Protocentral/protocentral_easyemg_hardware/hardware/protocentral-easyemg-schematic.pdf

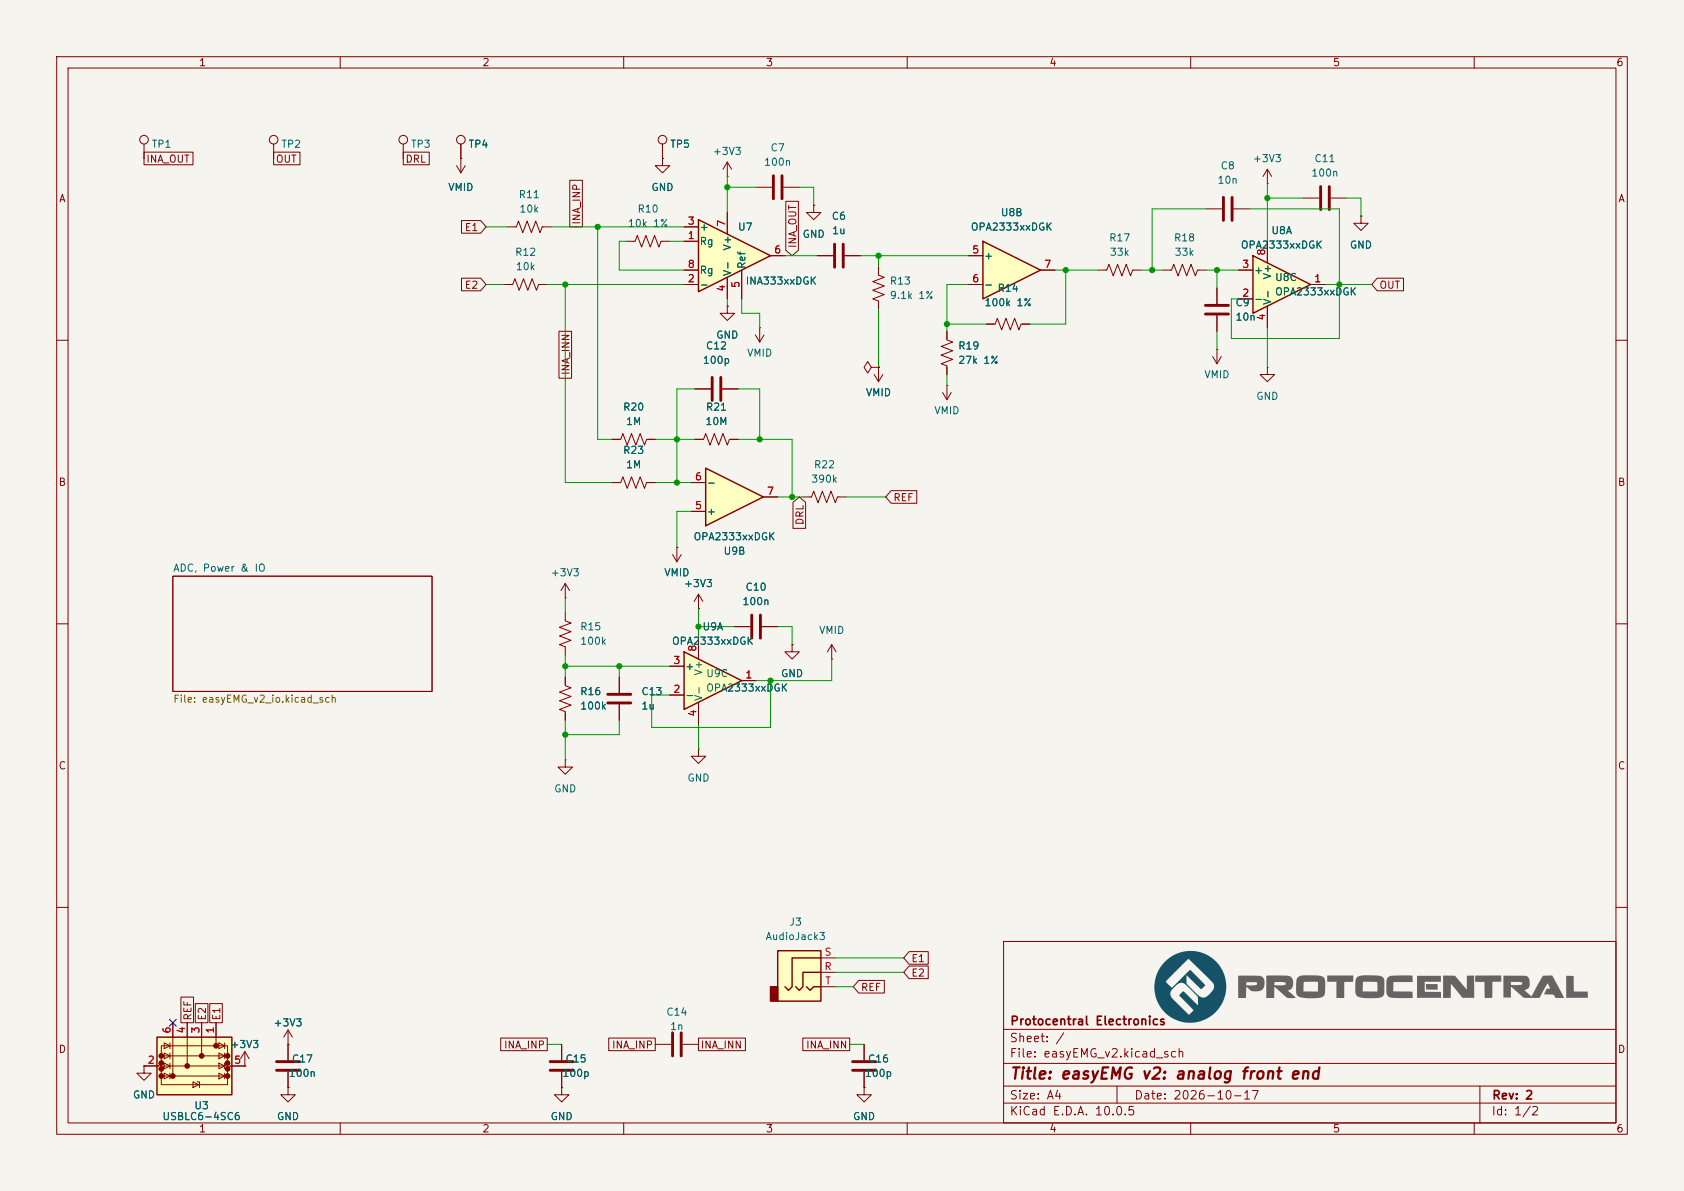
[picture p2: page 1]

Protocentral Electronics
Sheet: /
File: easyEMG_v2.kicad_sch
Title: easyEMG v2: analog front end

Size: A4 | Rev: 2
KiCad E.D.A. 10.0.5 | Id: 1/2

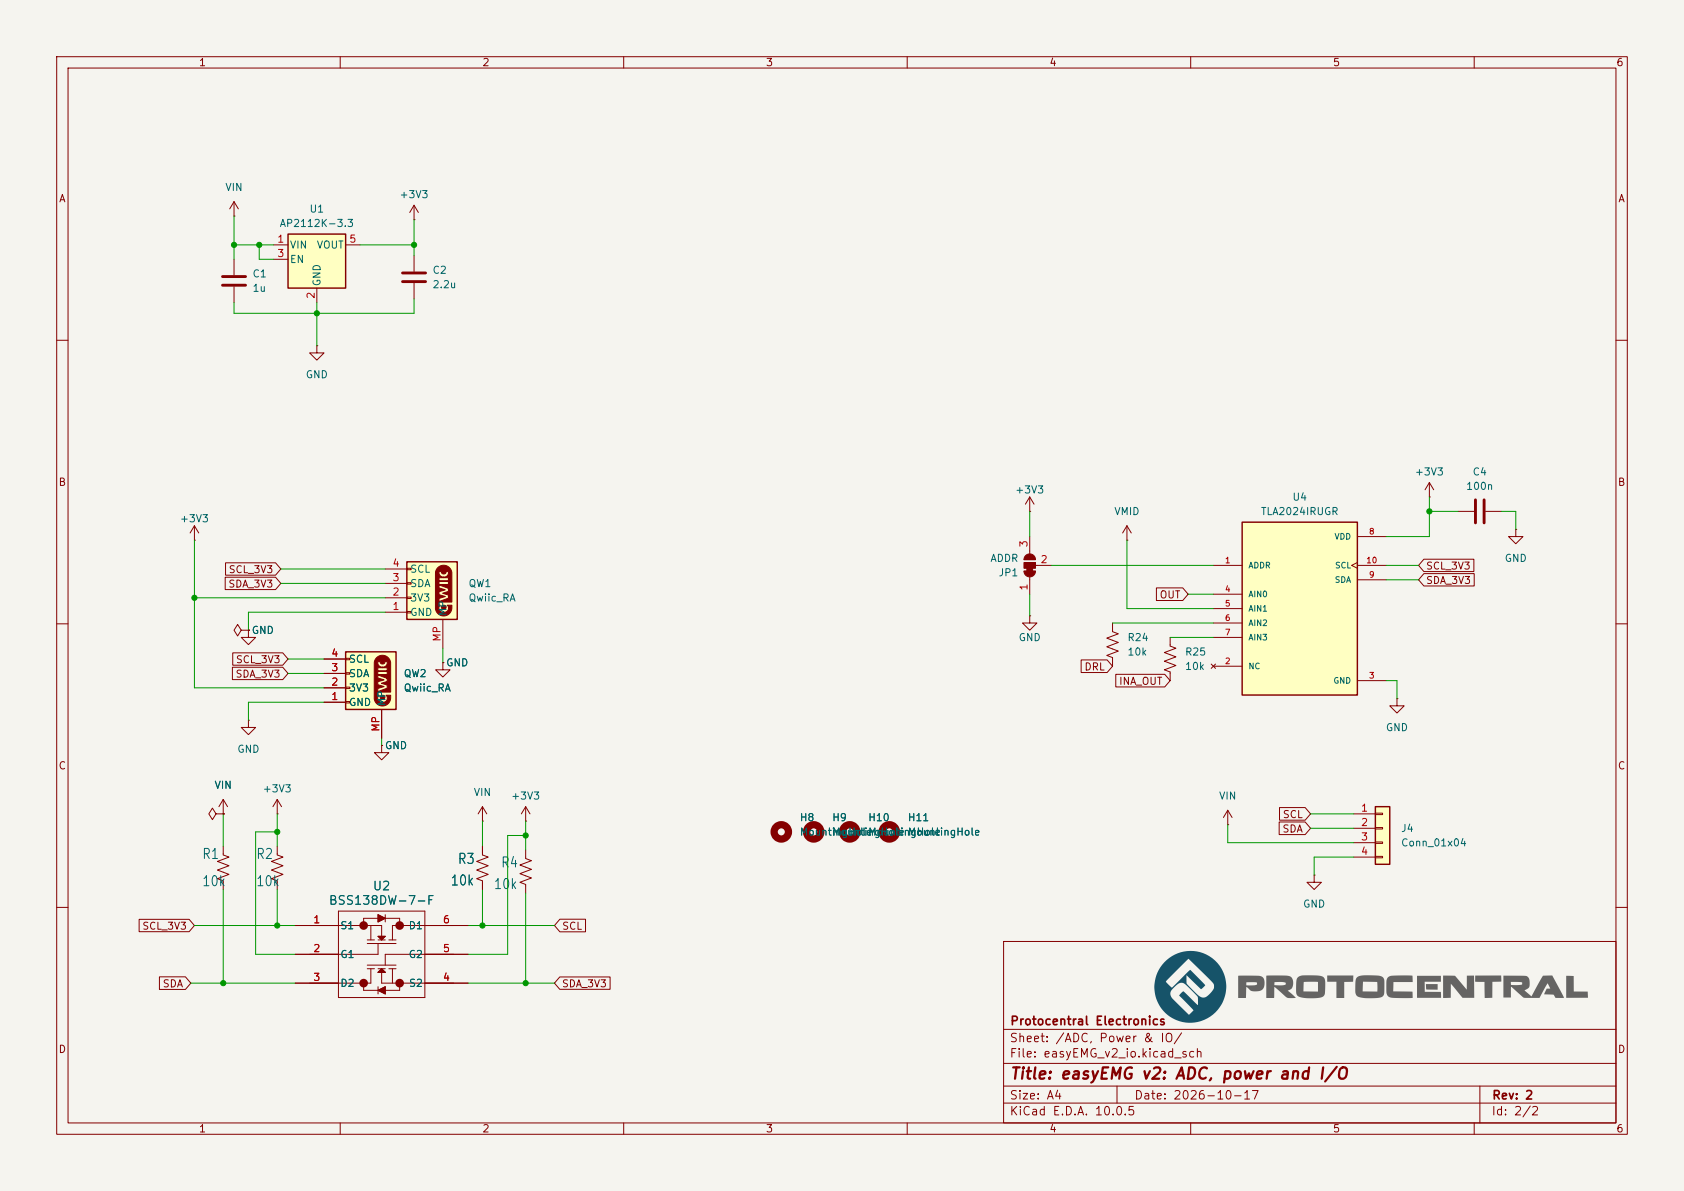
[picture p3: page 2]

Sheet: /ADC, Power & IO/
File: easyEMG_v2_io.kicad_sch
Title: easyEMG v2: ADC, power and I/O

Size: A4 | Rev: 2
KiCad E.D.A. 10.0.5 | Id: 2/2
