Protocentral/protocentral_easyemg_hardware/hardware/easyEMG_v2.kicad_pcb

## KiCad design hardware/easyEMG_v2.kicad_pcb (2026-11-07)

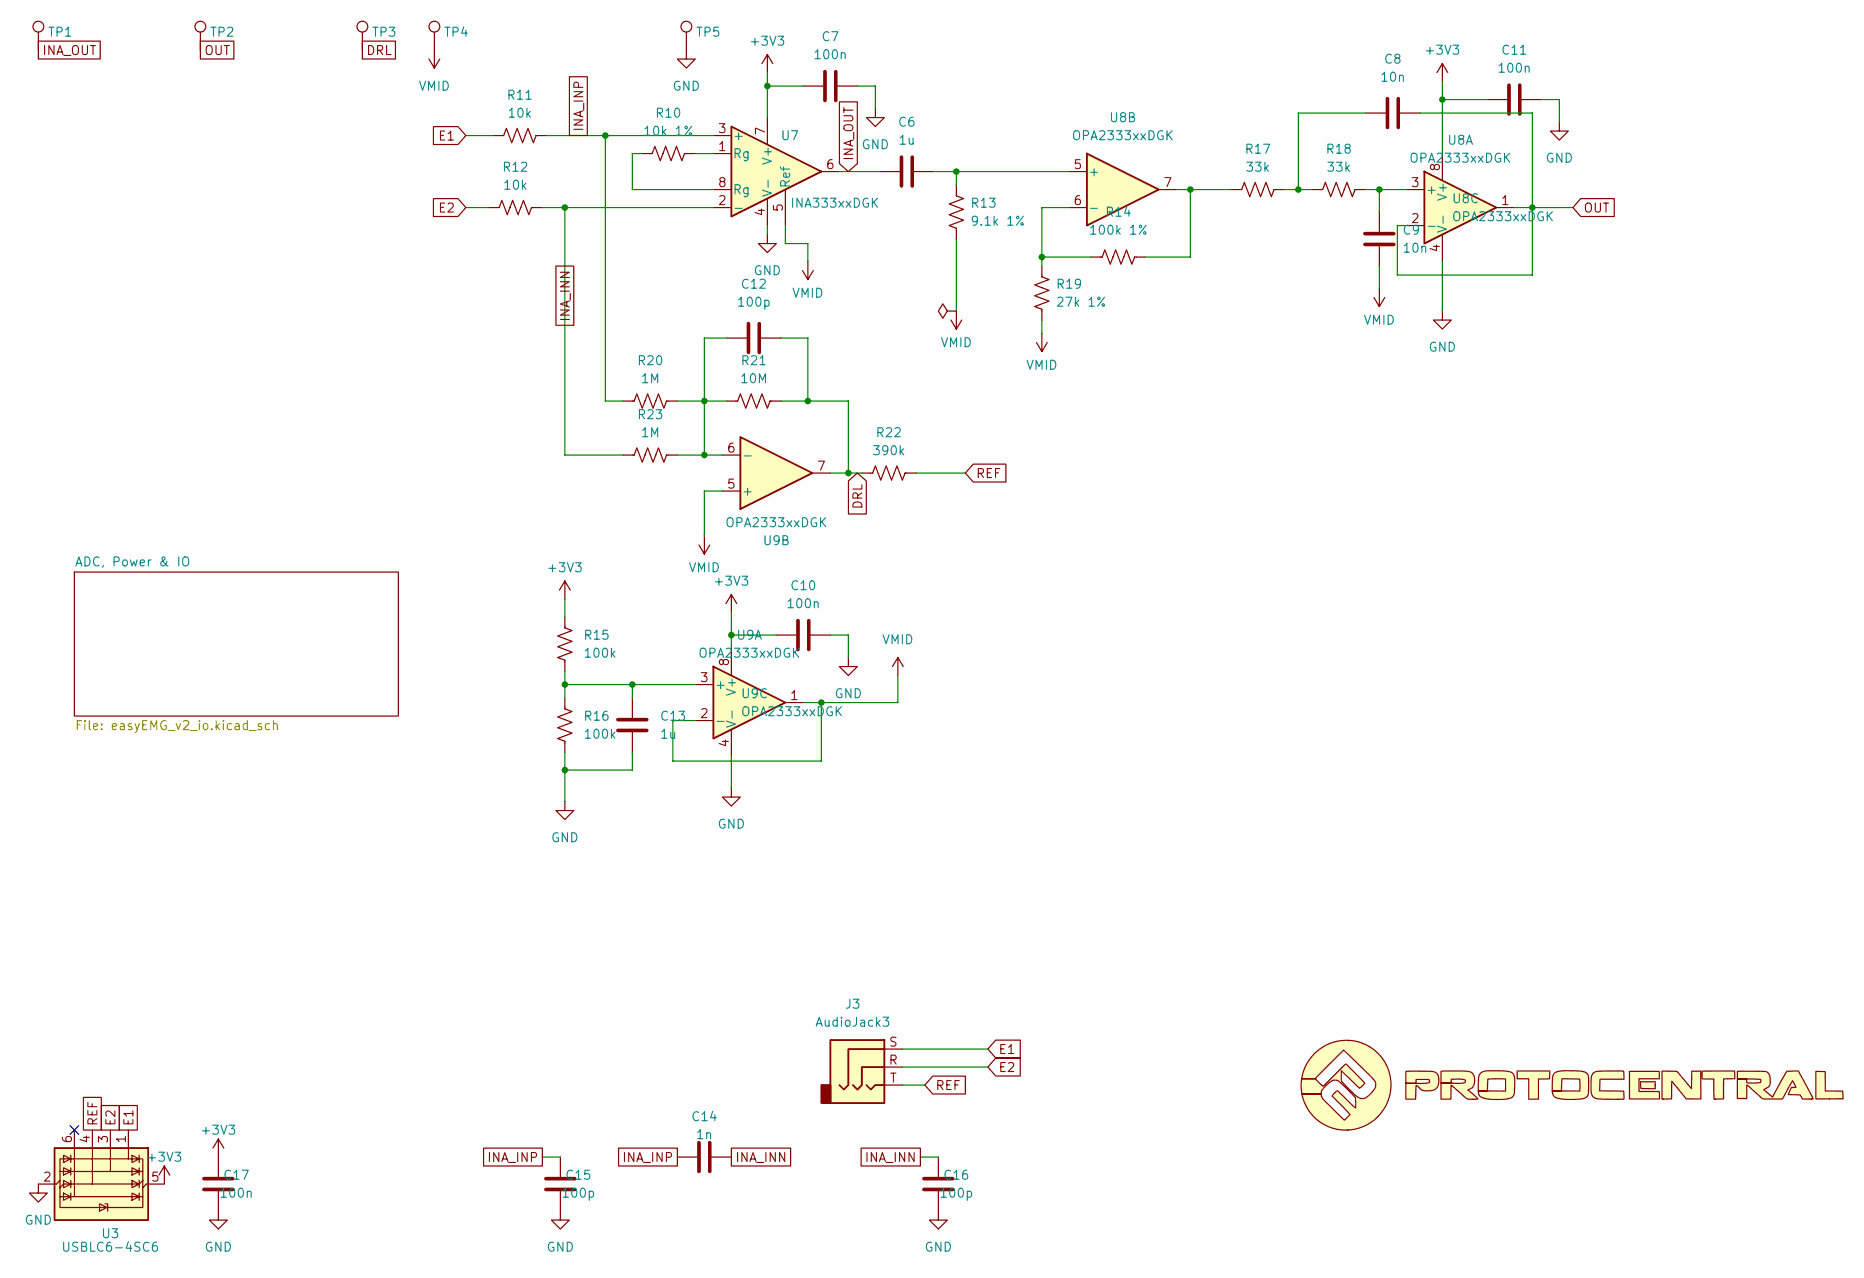
[picture p4: schematic easyEMG_v2.kicad_sch, easyEMG v2: analog front end]

Parts:
C6, C13: 1u; C_0402_1005Metric
C7, C10, C11, C17: 100n; C_0402_1005Metric
C8, C9: 10n; C_0402_1005Metric
C12, C15, C16: 100p; C_0402_1005Metric
C14: 1n; C_0402_1005Metric
J3: AudioJack3; Jack_3.5mm_CUI_SJ-3523-SMT_Horizontal
R10: 10k 1%; R_0402_1005Metric
R11, R12: 10k; R_0402_1005Metric
R13: 9.1k 1%; R_0402_1005Metric
R14: 100k 1%; R_0402_1005Metric
R15, R16: 100k; R_0402_1005Metric
R17, R18: 33k; R_0402_1005Metric
R19: 27k 1%; R_0402_1005Metric
R20, R23: 1M; R_0402_1005Metric
R21: 10M; R_0402_1005Metric
R22: 390k; R_0402_1005Metric
TP1: INA_OUT; TestPoint_Pad_D1.0mm
TP2: OUT; TestPoint_Pad_D1.0mm
TP3: DRL; TestPoint_Pad_D1.0mm
TP4: VMID; TestPoint_Pad_D1.0mm
TP5: GND; TestPoint_THTPad_D1.5mm_Drill0.7mm
U3: USBLC6-4SC6; SOT-23-6
U6: LOGO
U7: INA333xxDGK; VSSOP-8_3x3mm_P0.65mm
U8, U9: OPA2333xxDGK; VSSOP-8_3x3mm_P0.65mm

Connections:
+3V3: C7.2, C10.2, C11.2, C17.1, R15.1, U3.5 (VBUS), U7.7 (V+), U8.8 (V+), U9.8 (V+); also elsewhere on the board
DRL: C12.1, R21.2, R22.1, TP3.1 (1_1), U9.7; also elsewhere on the board
E1: J3.S, R11.1, U3.1 (I/O1)
E2: J3.R, R12.1, U3.3 (I/O2)
GND: C7.1, C10.1, C11.1, C13.2, C15.2, C16.2, C17.2, R16.2, TP5.1 (1_1), U3.2 (GND), U7.4 (V-), U8.4 (V-), U9.4 (V-); also elsewhere on the board
INA_INN: C14.2, C16.1, R12.2, R23.1, U7.2 (-)
INA_INP: C14.1, C15.1, R11.2, R20.1, U7.3 (+)
INA_OUT: C6.2, TP1.1 (1_1), U7.6; also elsewhere on the board
unnamed: C8.2, R17.1, R18.2
unnamed: R10.1, U7.8 (Rg)
unnamed: R10.2, U7.1 (Rg)
unnamed: R14.1, R17.2, U8.7
unnamed: C9.1, R18.1, U8.3 (+)
unnamed: C6.1, R13.2, U8.5 (+)
unnamed: R14.2, R19.1, U8.6 (-)
unnamed: C13.1, R15.2, R16.1, U9.3 (+)
unnamed: C12.2, R20.2, R21.1, R23.2, U9.6 (-)
OUT: C8.1, TP2.1 (1_1), U8.1, U8.2 (-); also elsewhere on the board
REF: J3.T, R22.2, U3.4 (I/O3)
VMID: C9.2, R13.1, R19.2, TP4.1 (1_1), U7.5 (Ref), U9.1, U9.2 (-), U9.5 (+); also elsewhere on the board

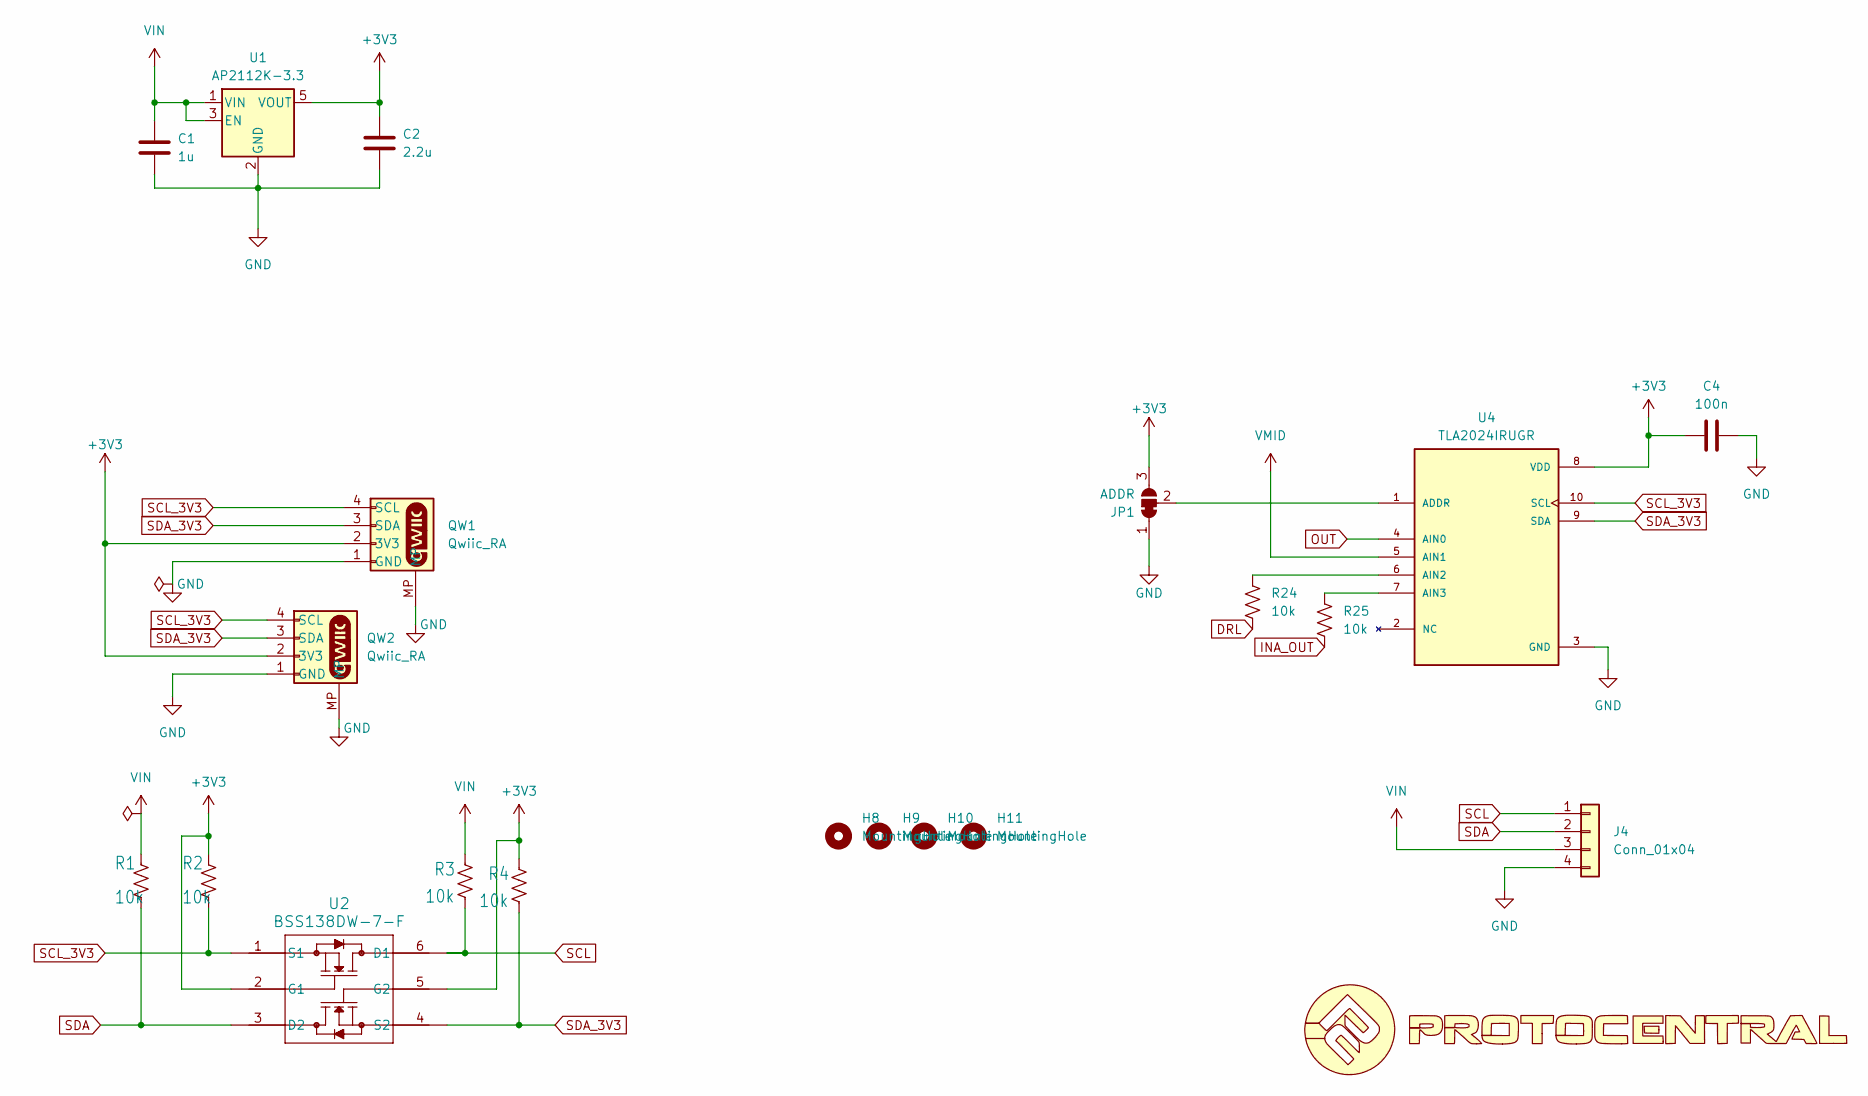
[picture p5: schematic easyEMG_v2_io.kicad_sch, easyEMG v2: ADC, power and I/O]

Parts:
C1: 1u; C_0402_1005Metric
C2: 2.2u; C_0402_1005Metric
C4: 100n; C_0402_1005Metric
H8, H9, H10, H11: MountingHole; MountingHole_2.2mm_M2
J4: Conn_01x04; PinHeader_1x04_P2.54mm_Vertical
JP1: ADDR; SolderJumper-3_P1.3mm_Bridged12_RoundedPad1.0x1.5mm
QW1, QW2: Qwiic_RA; JST_SH_SM04B-SRSS-TB_1x04-1MP_P1.00mm_Horizontal
R1, R2, R3, R4, R24, R25: 10k; R_0402_1005Metric
U1: AP2112K-3.3; SOT-23-5
U2: BSS138DW-7-F; SOT-363_SC-70-6
U4: TLA2024IRUGR; IC_TLA2024IRUGR; PARTREV November 2017

Connections:
+3V3: C2.1, C4.2, JP1.3 (B), QW1.2 (3V3), QW2.2 (3V3), R2.1, R4.1, U1.5 (VOUT), U2.2 (G1), U2.5 (G2), U4.8 (VDD); also elsewhere on the board
DRL: R24.2; also elsewhere on the board
GND: C1.2, C2.2, C4.1, J4.4, JP1.1 (A), QW1.1 (GND), QW1.MP, QW2.1 (GND), QW2.MP, U1.2 (GND), U4.3 (GND); also elsewhere on the board
INA_OUT: R25.2; also elsewhere on the board
unnamed: JP1.2 (C), U4.1 (ADDR)
unnamed: R24.1, U4.6 (AIN2)
unnamed: R25.1, U4.7 (AIN3)
OUT: U4.4 (AIN0); also elsewhere on the board
SCL: J4.1, R3.2, U2.6 (D1)
SCL_3V3: QW1.4 (SCL), QW2.4 (SCL), R2.2, U2.1 (S1), U4.10 (SCL)
SDA: J4.2, R1.2, U2.3 (D2)
SDA_3V3: QW1.3 (SDA), QW2.3 (SDA), R4.2, U2.4 (S2), U4.9 (SDA)
VIN: C1.1, J4.3, R1.1, R3.1, U1.1 (VIN), U1.3 (EN)
VMID: U4.5 (AIN1); also elsewhere on the board

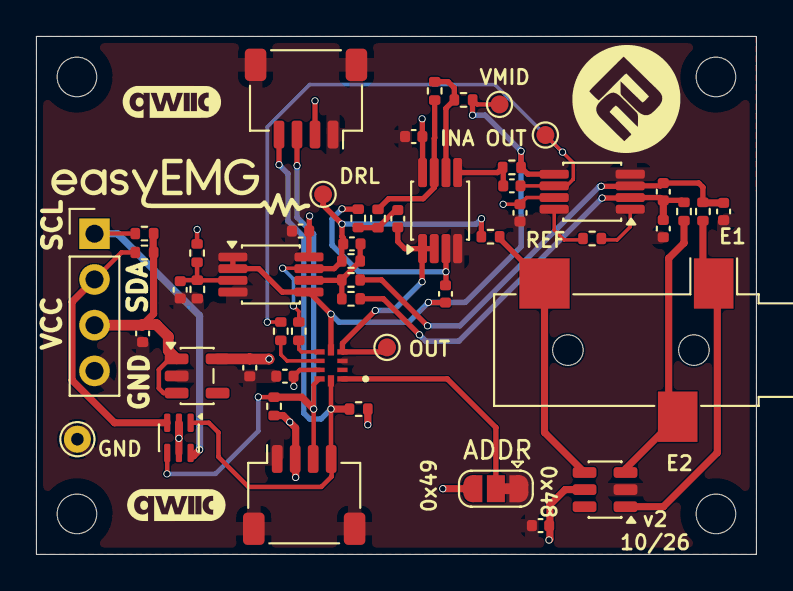
[picture p6: board easyEMG_v2.kicad_pcb from above]

Board: 2 copper layers, 40.0 x 28.8 mm, 56 parts (0 on the bottom side), 28 nets.
